domp47/FirebirdWiringHarness/deutschConnector.md

# Engine Connector
## 12 AWG
-  Ignition PWR
-  Injector PWR
-  Water Pump
-  Starter

## 18 AWG
- Trigger Source
- Bat GND Triggers
- Bat GND Knock Sensors

## 20 AWG
- Alternator Cntrl
- Knock Sensors x2
- Injectors x8
- Ignition x8
- IAC x4

## 22 AWG
- Sensor +5v A
- Sensor +5v B
- Sensor GND A
- Sensor GND B
- TPS
- MAP
- IAT
- Coolant Temp
- Coolant Press
- Oil Temp
- Oil Press
- Fuel Pressure

## Total Engine
- x4  -  12 AWG @ 25 AMP
- x3  -  18 AWG @ 8  AMP
- x23 -  20 AWG @ 3  AMP
- x12 -  22 AWG @ 1  AMP

### 42 Connections

## Connectors
- DTP04-4P-L012 4 pin Flange for 12 awg
- HD34-24-47SE 47 Pin Connector for 18-20-22 AWGs

# Accessory Connector
## 12 AWG
- Rad Fan
- Horn

## 18 AWG
- LineLock
- Boost +
- Boost - 
- HighBeams
- LowBeams x2

## 20 AWG
- Indicators x2

## Total:
- x2  -  12 AWG @ 25 AMP
- x6  -  18 AWG @ 8  AMP
- x2 -  20 AWG @ 3  AMP

### 10 Connections

## Connectors
- DTP04-4P-L012 4 pin Flange for 12 awg
- DT04-08PA-L012 8 Pin flange

# Overall
## 12 AWG
- Ignition PWR
- Injector PWR
- Water Pump
- Rad Fan
- Starter
- Horn

## 18 AWG
- LineLock
- Boost +
- Boost - 
- HighBeams
- LowBeams x2
- Trigger Source
- Bat GND Triggers
- Bat GND Knock Sensors

## 20 AWG
- Indicators x2
- Alternator Cntrl
- Knock Sensors x2
- Injectors x8
- Ignition x8
- IAC x4

## 22 AWG
- Sensor +5v A
- Sensor +5v B
- Sensor GND A
- Sensor GND B
- TPS
- MAP
- IAT
- Coolant Temp
- Coolant Press
- Oil Temp
- Oil Press
- Fuel Pressure

## Total:
- x6  -  12 AWG @ 25 AMP
- x9  -  18 AWG @ 8  AMP
- x25 -  20 AWG @ 3  AMP
- x12 -  22 AWG @ 1  AMP

### 52 Connections
