domp47/FirebirdWiringHarness/duestchConnecto2.md

# Injector Harness
- 12 AWG PWR
- 20 AWG GND x8

## Connector
- HD36-24-14SN: x1 Size 4, x1 Size 12, x12 Size 16

# Coil Harness
- 12 AWG Ignition PWR
- 20 AWG Ignition x8

## Connector
- HD36-24-14SN: x1 Size 4, x1 Size 12, x12 Size 16

# Engine Harness
#### 12 AWG
-  Water Pump

#### 14 AWG
- Starter

#### 20 AWG
- Trigger Source
- Bat GND Triggers
- Bat GND Knock Sensors
- Alternator Cntrl
- Knock Sensors x2
- Sensor +5v A
- Sensor +5v B
- Sensor GND A
- Sensor GND B
- TPS
- MAP
- IAT
- Coolant Temp
- Coolant Press
- Oil Temp
- Oil Press
- Fuel Pressure

### Total Engine
- x2  -  12 AWG @ 25 AMP
- x3  -  18 AWG @ 8  AMP
- x7  -  20 AWG @ 3  AMP
- x12 -  22 AWG @ 1  AMP

***

- x2 Size 12
- x22 Size 20 **OR** x10 Size 16 & x12 Size 20

## Connector
- HD36-18-8SE: x8 Size 12
- HD36-24-35SN: x3 Size 16, x32 Size 20

# Accessory Harness
### 12 AWG
- Rad Fan
- Horn

### 18 AWG
- LineLock
- Boost +
- Boost - 
- HighBeams
- LowBeams x2

### 20 AWG
- Indicators x2

### Total Accessory
- x2  -  12 AWG @ 25 AMP
- x6  -  18 AWG @ 8  AMP
- x2 -  20 AWG @ 3  AMP

***
- x2 Size 12
- x8 Size 20 **OR** x8 Size 16

## Connector
-  HD36-24-21PE: x4 Size 12, x17 Size 16
