domp47/FirebirdWiringHarness/firewallConnectors.md

## Injector 
### HD34-24-21SN/ HD36-24-21PN

- Size 12 Socket x1: 0462-203-12141
- Size 12 Pin x1: 0460-204-12141

- Size 16 Socket x8: 0462-201-16141
- Size 16 Pin x8: 0460-202-16141

- Socket Plug x12: 114017
- Pin Plug x12: 0413-217-1605

- Gasket: 16-04477
- Nut: 112263-90
- Washer: 112264

| Pin # | Description | Color | Size | Note |
|:-----:|:---:|:---:|:----:|:----:|
| A | N/C | |  16  | |
| B | INJ 12v | Red/ Light Blue  |  12  | |
| C | INJ 5 | Light Blue/ Orange |  16  | |
| D | N/C | |  12  | |
| E | N/C | |  12  | |
| F | N/C | |  16  | |
| G | N/C | |  12  | |
| H | INJ 1 | Light Blue |  16  | |
| J | INJ 2 |  Light Blue/ Black |  16  | |
| K | INJ 3 |  Light Blue/ Brown |  16  | |
| L | INJ 4 | Light Blue/ Red  |  16  | |
| M | INJ 6 | Light Blue/ Yellow |  16  | |
| N | INJ 7 |  Light Blue/ Green |  16  | |
| P | INJ 8 | Light Blue/ Violet |  16  | |
| R | N/C | |  16  | |
| S | N/C | |  16  | |
| T | N/C | |  16  | |
| U | N/C | |  16  | |
| V | N/C | |  16  | |
| W | N/C | |  16  | |
| X | N/C | |  16  | |

## Coil & Wideband
### HD34-24-29SE/ HD36-24-29PE

- Size 12 Socket x1: 0462-203-12141
- Size 12 Pin x1: 0460-204-12141

- Size 16 Socket x14: 0462-201-16141
- Size 16 Pin x14: 0460-202-16141

- Size 20 Socket x6: 0462-201-20141
- Size 20 Pin x6: 0460-202-20141

- Socket Plug x8: 114017
- Pin Plug x8: 0413-217-1605

- Gasket: 16-04477
- Nut: 112263-90
- Washer: 112264

| Pin # |  Description | Color | Size | Note |
|:-----:|:---:|:---:|:----:|:---:|
| 1 | Ignition 12v | Red/ Yellow |  12  | |
| 2 | N/C | |  12  | |
| 3 | N/C | |  12  | |
| 4 | N/C | |  12  | |
| 5 | IGN 1 | Yellow/ Black |  16  | |
| 6 | IGN 2 | Yellow/ Red |  16  | |
| 7 | IGN 3 | Yellow/ Orange |  16  | |
| 8 | IGN 4 | Yellow/ Green |  16  | |
| 9 | IGN 5 | Yellow/ Brown |  16  | |
| 10  | IGN 6 | Yellow/ Light Blue |  16  | |
| 11  | N/C | |  16  | |
| 12  | N/C | |  16  | |
| 13  | IGN 7 | Yellow/ Violet |  16  | |
| 14  | IGN 8 | Yellow/ Gray |  16  | |
| 15  | N/C | |  16  | |
| 16  | N/C | |  16  | |
| 17  | N/C | |  16  | |
| 18  |  WBC B1 HTR+ | Gray |  20  | |
| 19  |  WBC B2 COM  | Yellow |  16  | |
| 20  |  WBC B3 Pump | Red |  20  | |
| 21  |  WBC B4 Cell | Black |  16  | |
| 22  |  WBC B5 HTR- | White |  16  | |
| 23  | WBC B6 CAL-R | Green |  20  | |
| 24  |  WBC A1 HTR+ | Gray |  20  | Not Used |
| 25  |  WBC A2 COM  | Yellow |  16  | Not Used |
| 26  |  WBC A3 Pump | Red |  16  | Not Used |
| 27  |  WBC A4 Cell | Black |  20  | Not Used |
| 28  |  WBC A5 HTR- | White |  16  | Not Used |
| 29  | WBC A6 CAL-R | Green |  20  | Not Used |

## Engine Connector
### HD34-24-35SN/ HD36-24-35PN

- Size 20 Socket x19: 0462-201-20141
- Size 20 Pin x19: 0460-202-20141
- Size 20 Plug x13: 0413-204-2005

- Size 16 Socket x1: 0462-209-16141
- Size 16 Pin x1: 0460-215-16141
- Size 16 Plug x3: 114017

- Gasket: 16-04477
- Nut: 112263-90
- Washer: 112264

| Pin # | Description | Color | Size | Note |
|:-----:|:---:|:---:|:----:|:---:|
| 1 | Shield Crank/Cam GND | Bare |  20  | |
| 2 | Crank Trigger + | Yellow |  20  | |
| 3 | Cam Trigger + | Yellow |  20  | |
| 4 | Sensor GND | Black |  20  | |
| 5 | 12v Switched HCO | ??? |  20  | For Crank/Cam Sensors |
| 6 | Knock 1 | White |  20  | |
| 7 | Starter Solenoid | ??? |  16  | |
| 8 | Sensor +5v | Orange |  20  | |
| 9 | TPS Signal | White |  20  | |
| 10  | MAP Signal | White/ Yellow |  20  | |
| 11  | N/C | |  16  | |
| 12  | IAT Signal |  White/ Gray  |  20  | |
| 13  | Coolant Temp Signal | White/ Violet |  20  | |
| 14  | N/C | |  16  | |
| 15  | Shield Knock GND | Bare |  20  | |
| 16  | Knock 2 | White |  20  | |
| 17  | Coolant Pressure Signal |  White/ Green |  20  | |
| 18  | Oil Temp Signal | White/ Orange |  20  | |
| 19  | Oil Pressure Signal |  White/ Black |  20  | |
| 20  | Fuel Pressure |  White/ Brown |  20  | |
| 21  | Torque Converter Pressure Signal |  Green/ Black |  20  | |
| 22  | Trans Line Pressure Signal |  Green/ Brown |  20  | |
| 23  | Trans Fluid Temp Signal | Green/ Red  |  20  | |
| 24  | N/C | |  20  | |
| 25  | N/C | |  20  | |
| 26  | N/C | |  20  | |
| 27  | N/C | |  20  | |
| 28  | N/C | |  20  | |
| 29  | N/C | |  20  | |
| 30  | N/C | |  20  | |
| 31  | N/C | |  20  | |
| 32  | N/C | |  20  | |
| 33  | N/C | |  20  | |
| 34  | N/C | |  20  | |
| 35  | N/C | |  20  | |

## Accessory & HC Power 
### HD34-24-21SN/ HD36-24-21PN

- Size 12 Socket x3: 0462-203-12141
- Size 12 Pin x3: 0460-204-12141

- Size 16 Socket x9: 0462-201-16141
- Size 16 Pin x9: 0460-202-16141

- Socket Plug x9: 114017
- Pin Plug x9: 0413-217-1605

- Gasket: 16-04477
- Nut: 112263-90
- Washer: 112264

| Pin # | Description | Color | Size | Note |
|:-----:|:---:|:-----:|:----:|:---:|
| A | Line Lock |  ???  |  16  | |
| B | Water Pump |  ???  |  12  | |
| C | 12v Switched HCO |  ???  |  16  | For Boost Solenoids |
| D | Rad Fan |  ???  |  12  | |
| E | Horn |  ???  |  12  | |
| F | High Beams |  ???  |  16  | |
| G | N/C | |  12  | |
| H |  Driver Low Beam |  ???  |  16  | |
| J | Pass Low Beam  |  ???  |  16  | |
| K | N/C | |  16  | |
| L | Boost + |  ???  |  16  | |
| M | Boost - |  ???  |  16  | |
| N | Signal Left |  ???  |  16  | |
| P | Signal Right |  ???  |  16  | |
| R | N/C | |  16  | |
| S | N/C | |  16  | |
| T | N/C | |  16  | |
| U | N/C | |  16  | |
| V | N/C | |  16  | |
| W | N/C | |  16  | |
| X | N/C | |  16  | |
