domp47/FirebirdWiringHarness/Manuals/turnsignalschematic.jpg

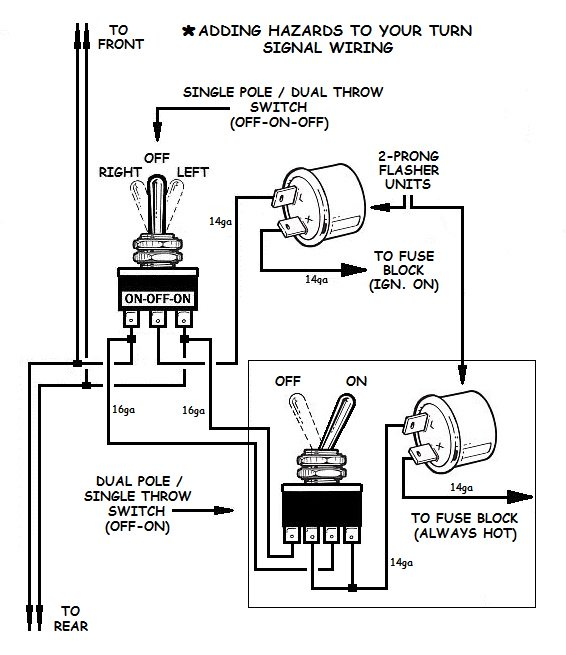
Manuals/turnsignalschematic.jpg
