domp47/FirebirdWiringHarness/PrintOuts/EngineBay.pdf

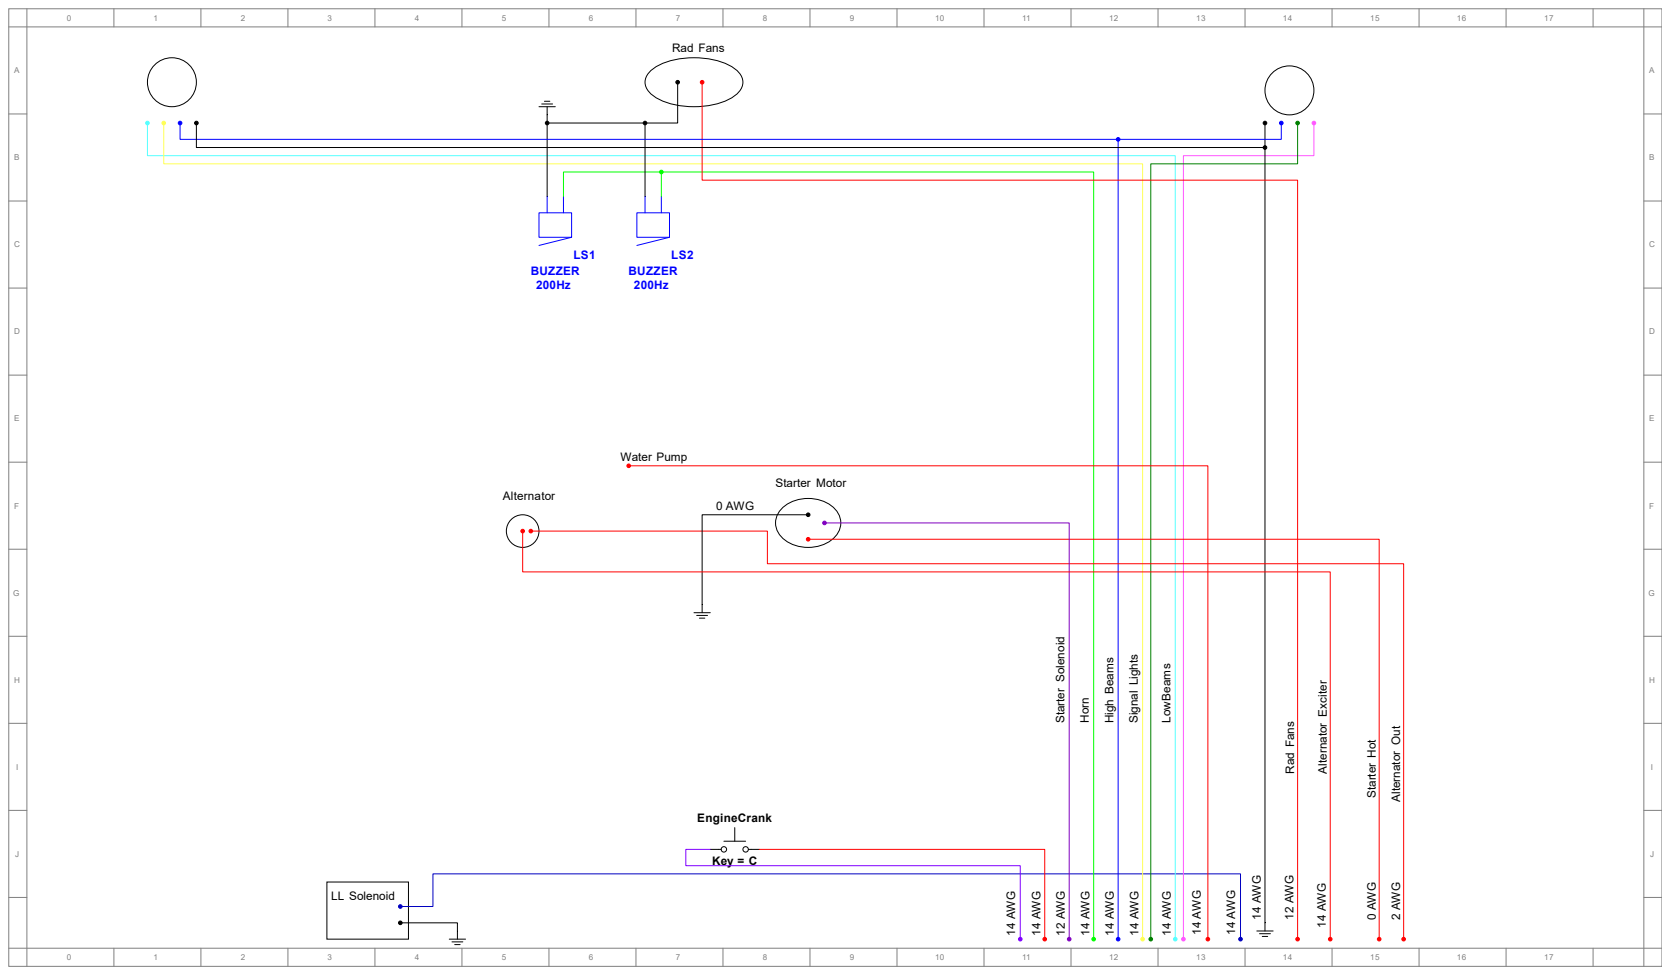
[picture p2: page 1]
J 14 AWG; LL Solenoid; 14 AWG; High Beams; Signal Lights; LowBeams; LS1 BUZZER 200Hz; LS2 BUZZER 200Hz; Horn; Starter Motor; Starter Hot; Alternator; Alternator Out; 0 AWG; 2 AWG; EngineCrank; Key = C; Rad Fans; Water Pump

12 AWG Starter Solenoid

Alternator Exciter 14 AWG

12 AWG Rad Fans
