domp47/FirebirdWiringHarness/PrintOuts/Trunk.pdf

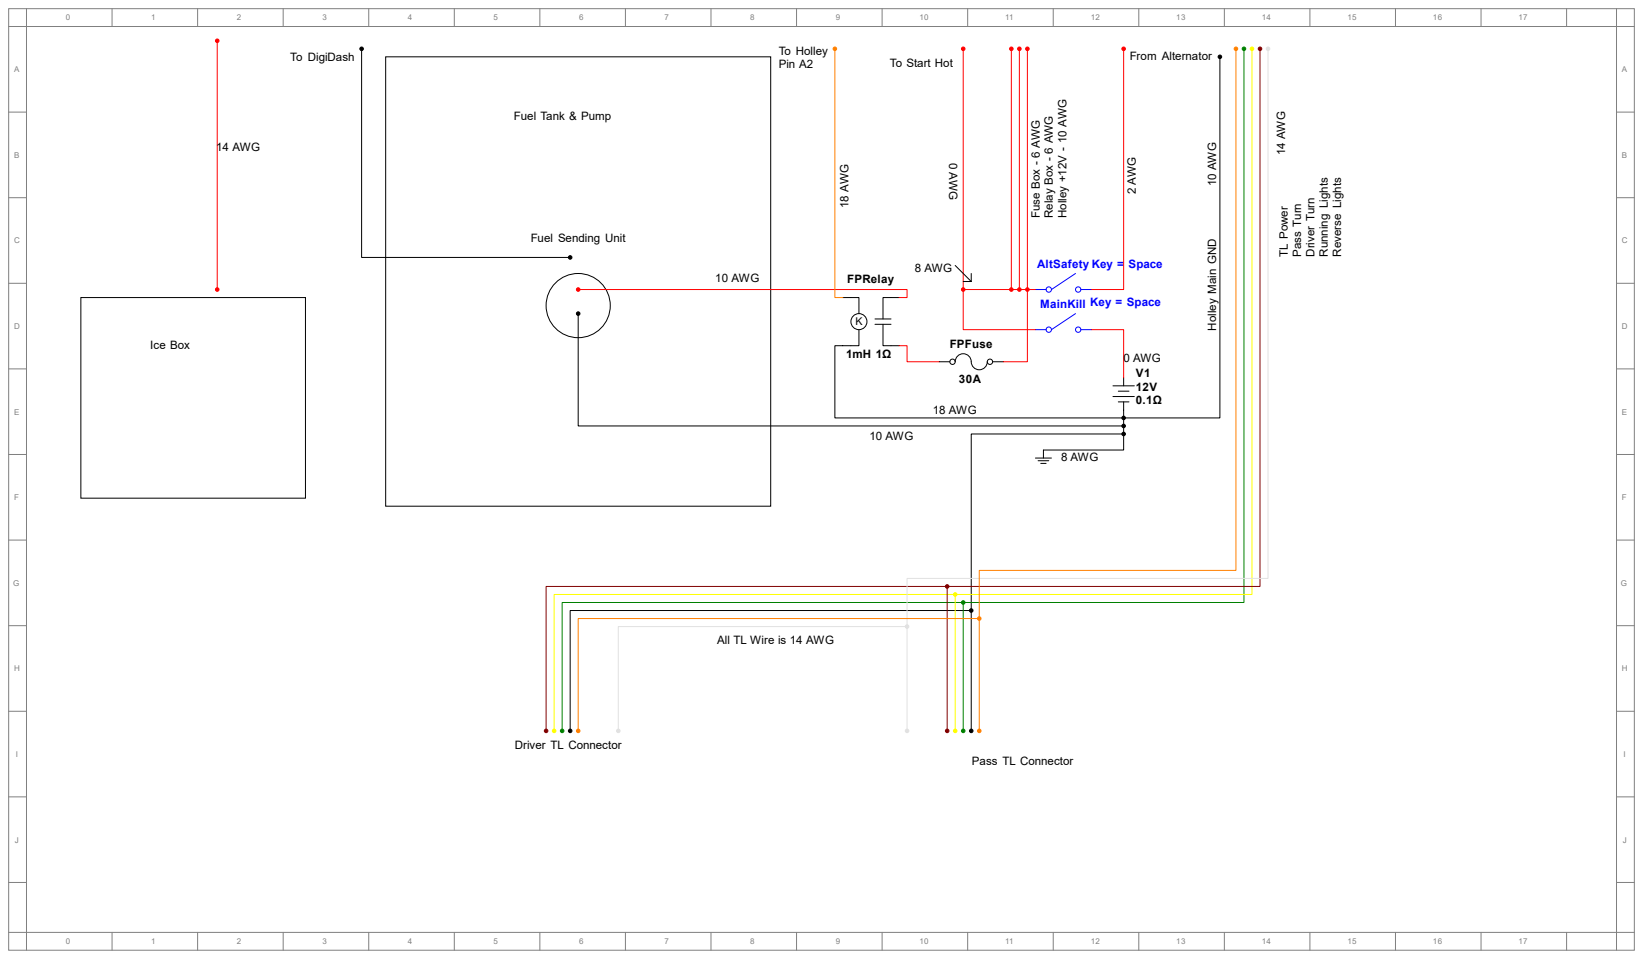
[picture p3: page 1]
To Start Hot; From Alternator 2 AWG; 8 AWG; FPRelay; FPFuse; To DigiDash; To Holley; Pin A2; 0 AWG; Holley +12V - 10 AWG; 10 AWG; TL Power; Pass Turn; Driver Turn; Running Lights; Reverse Lights; 18 AWG; 14 AWG; Ice Box

Fuel Tank & Pump

Fuse Box - 6 AWG

Relay Box - 6 AWG

10 AWG Holley Main GND

Fuel Sending Unit

AltSafety Key = Space

MainKill Key = Space

All TL Wire is 14 AWG

Driver TL Connector

Pass TL Connector
