domp47/FirebirdWiringHarness/PrintOuts/Cabin.pdf

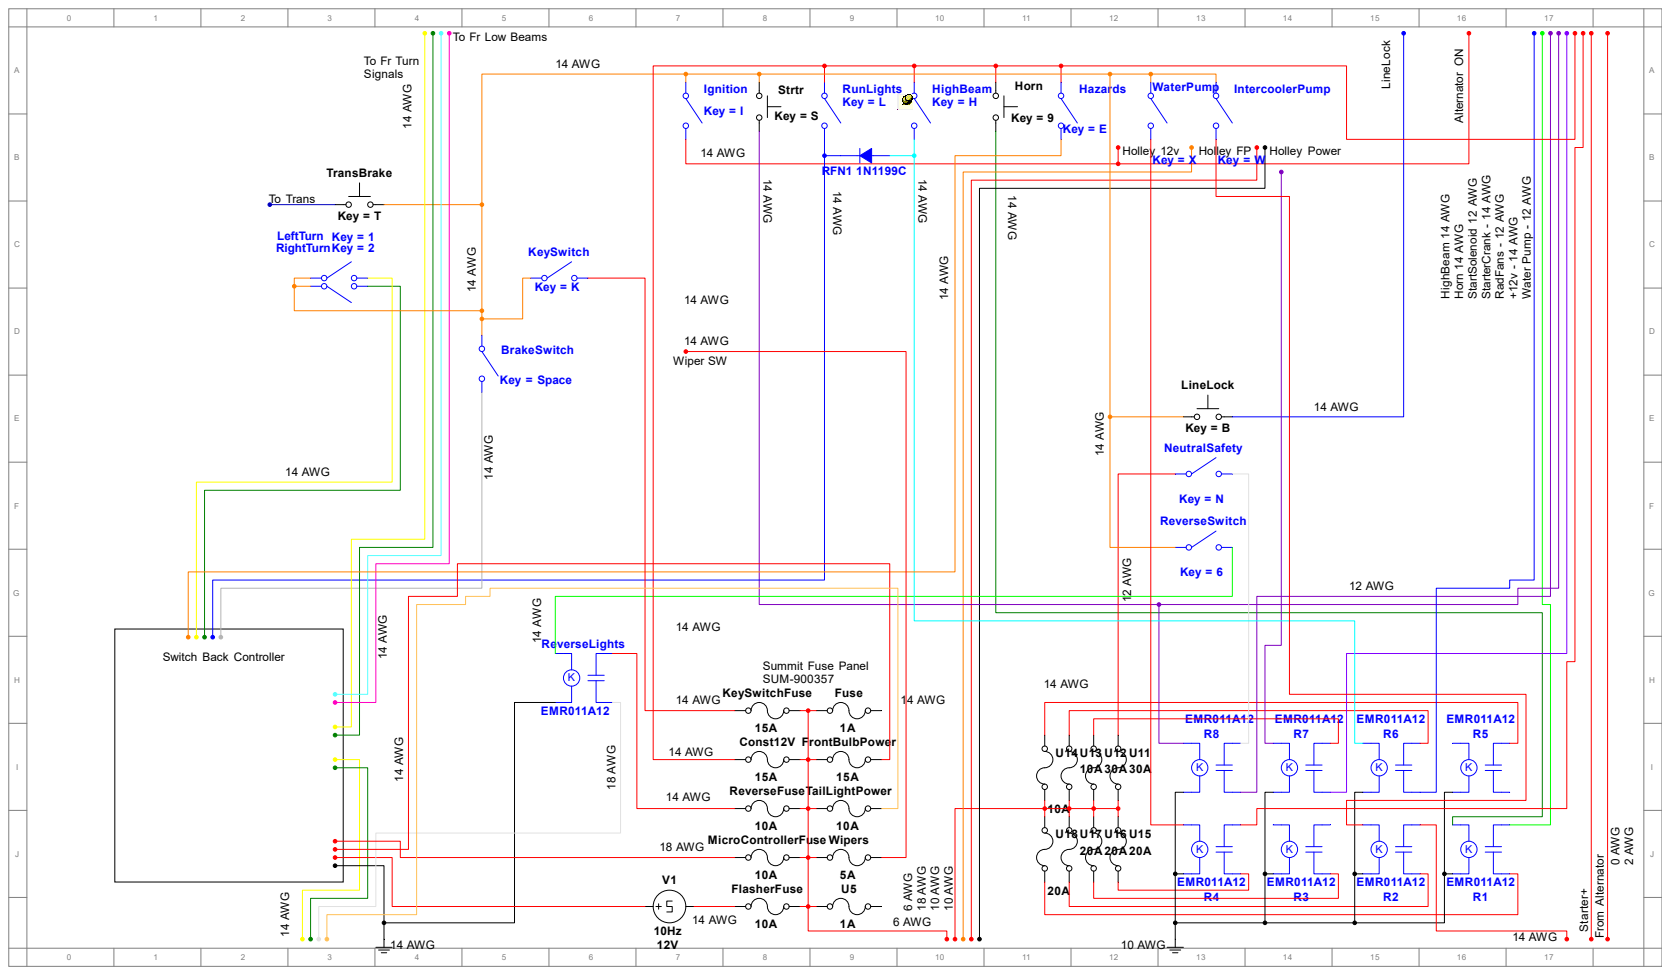
[picture p4: page 1]

To Fr Low Beams
