domp47/FirebirdWiringHarness/PrintOuts/SwitchBack.pdf

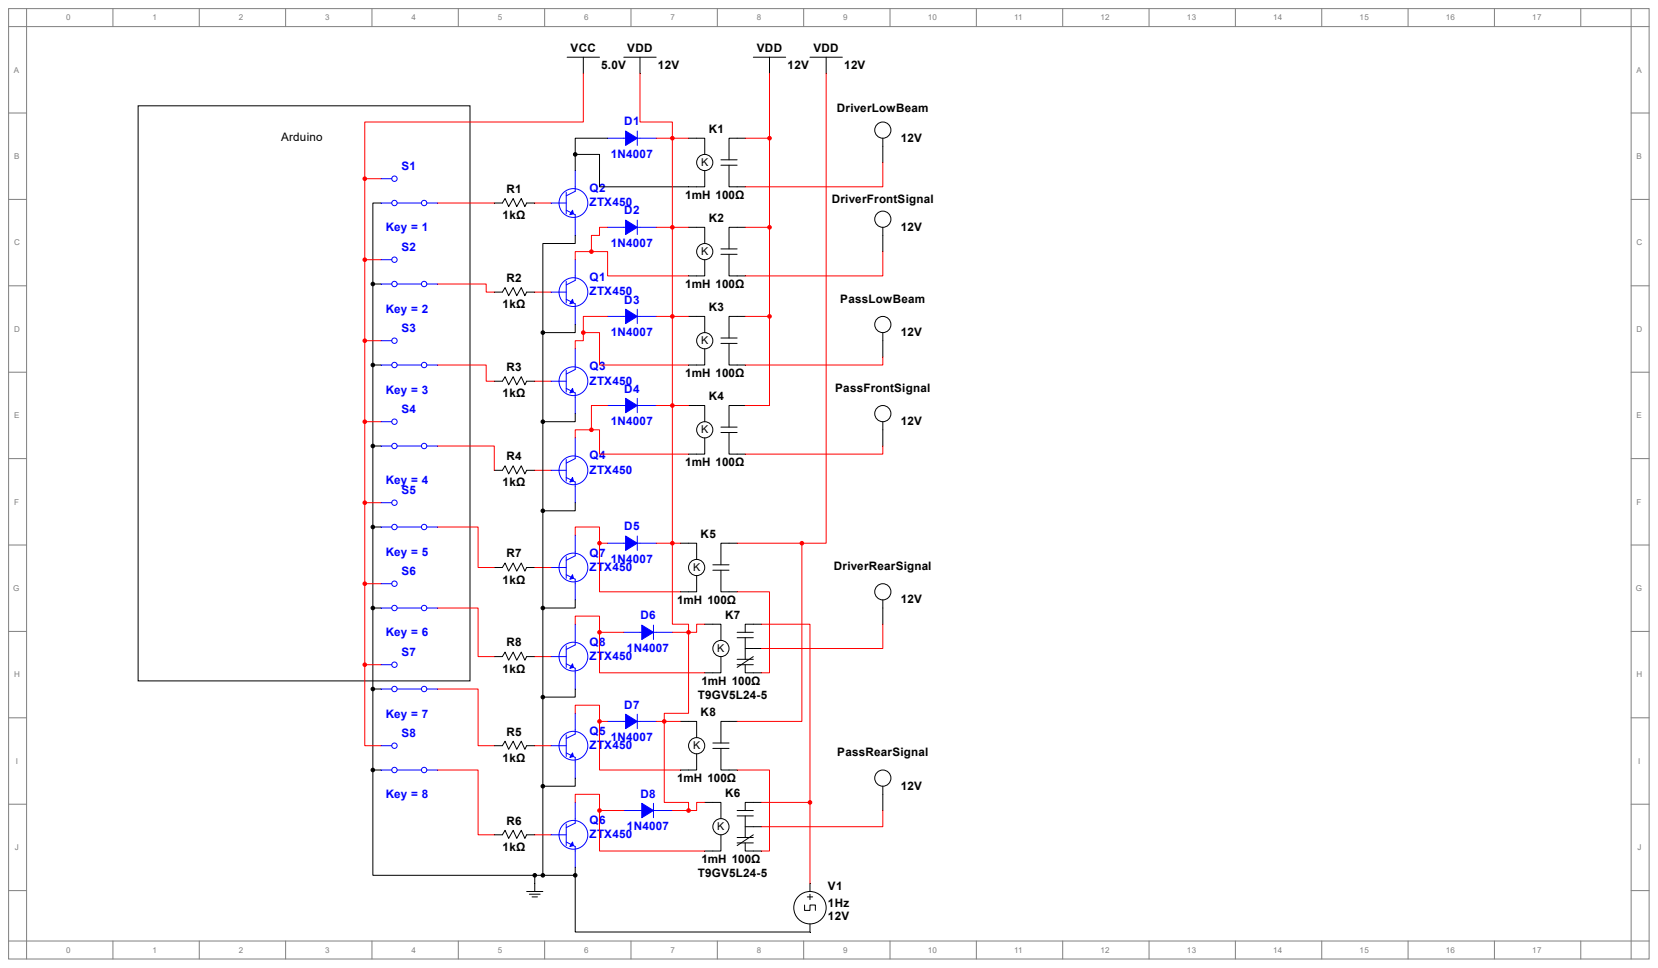
[picture p5: page 1]
