domp47/FirebirdWiringHarness/(list of files, drawings)

Other design files:
Schematics/Haltech/Engine.ms14
Schematics/Haltech/Trunk.ms14
Schematics/Holley/Cabin.ms14
Schematics/Holley/EngineBay.ms14
Schematics/Holley/Misc/12vInput.ms14
Schematics/Holley/Misc/Diagram.ms14
Schematics/Holley/Misc/SignalClean.ms14
Schematics/Holley/Misc/Signals.backup.ms14
Schematics/Holley/Misc/Signals.ms14
Schematics/Holley/SwitchBackController.ms14
Schematics/Holley/Trunk.ms14
