domp47/FirebirdWiringHarness/PrintOuts/12v.pdf

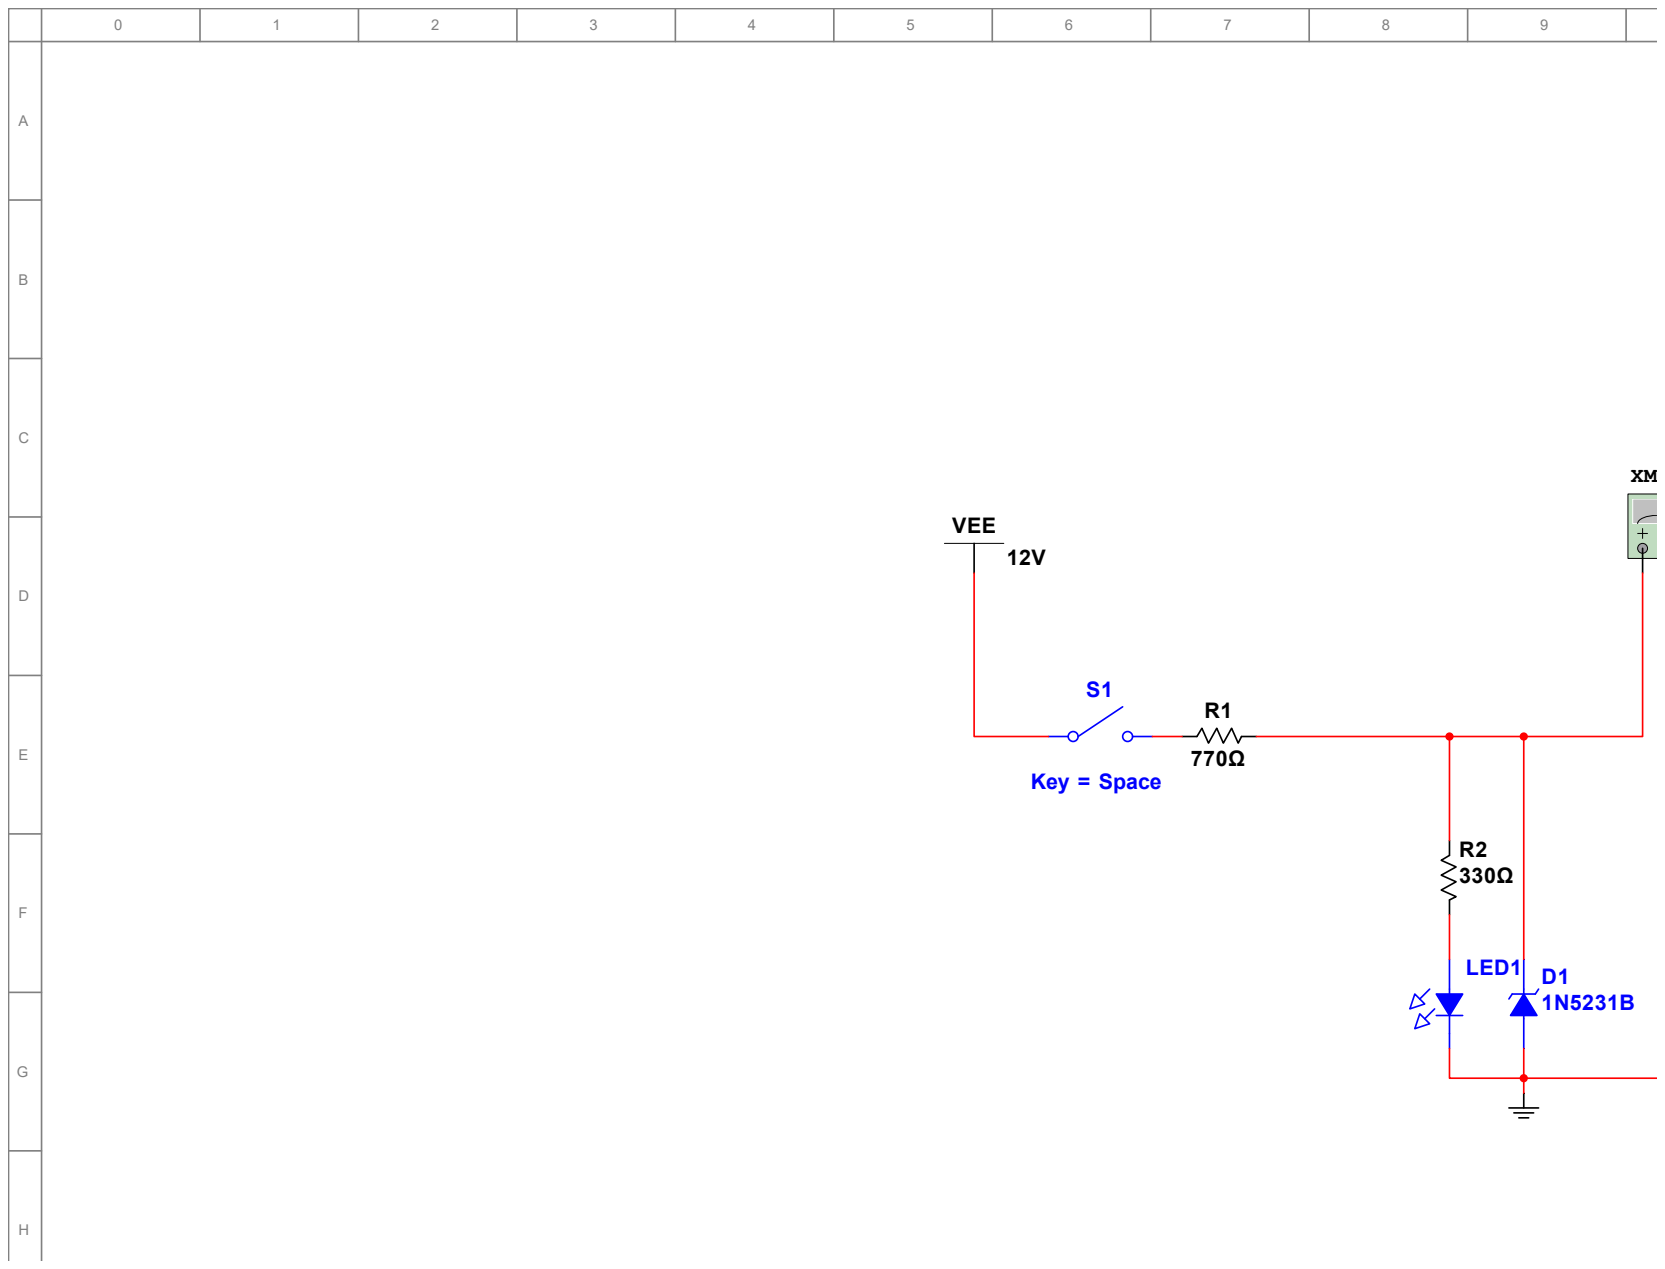
[picture p6: page 1]
VEE; Key = Space; XMM1; LED1

10 | 11 | 12 | 13 | 14 | 15 | 16 | 17

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
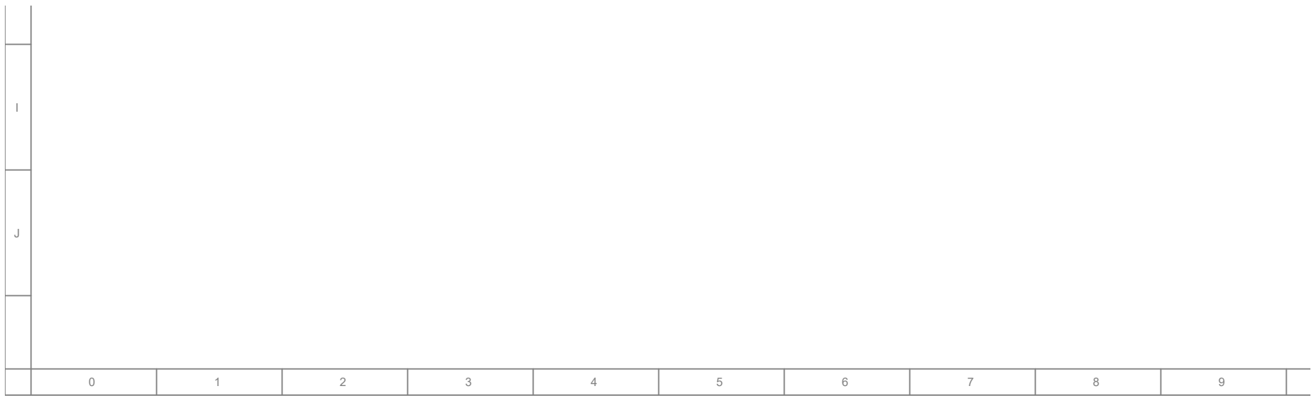
[picture p7: figure]

10 | 11 | 12 | 13 | 14 | 15 | 16 | 17 | IJ
