domp47/FirebirdWiringHarness/(commit log)

2020-09-05 added trunk and cabin sections
    [Cabin.ms14, Diagram.ms14, SignalClean.ms14, Signals.backup.ms14, Signals.ms14, Trunk.ms14]
2020-09-05 pre microcontroller
    [Cabin.ms14, EngineBay.ms14, Trunk.ms14]
2020-09-07 its done
    [Cabin.ms14, EngineBay.ms14, SwitchBackController.ms14, Trunk.ms14]
2020-09-15 cleaned up repo and added printouts
    [Cabin.ms14, Diagram.ms14, EngineBay.ms14, SignalClean.ms14, Signals.backup.ms14, Signals.ms14, SwitchBackController.ms14, Trunk.ms14]
2020-10-04 changed schematics for turbo and 71 front end
    [12vInput.ms14, Cabin.ms14, EngineBay.ms14, SwitchBackController.ms14, Trunk.ms14]
